kerikun11/AkiShelf/README.md

# AkiShelf
Display of Akizuki's Shelf Number
