kerikun11/AkiShelf/kicad/aki-shelf.pdf

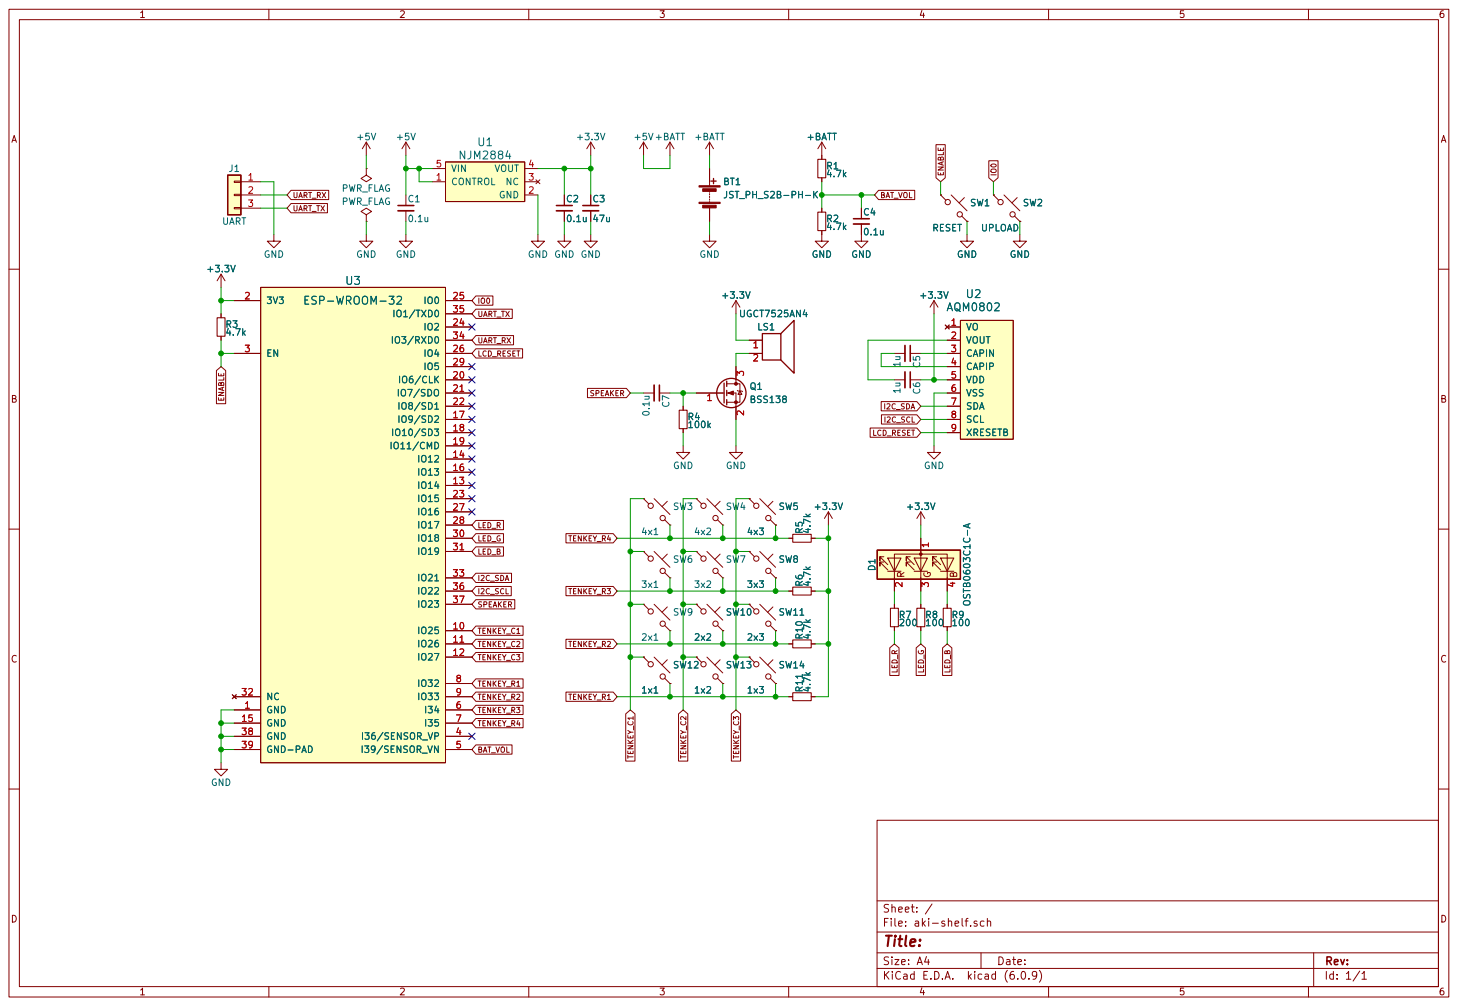
[picture p1: page 1]

Id: 1/1 Title: File: aki-shelf.sch Sheet: / SW7
