kerikun11/AkiShelf/(list of files, drawings)

Other design files:
kicad/aki-shelf.dsn
