kerikun11/AkiShelf/kicad/aki-shelf.kicad_pcb

## KiCad design kicad/aki-shelf.kicad_pcb (2018-04-30)

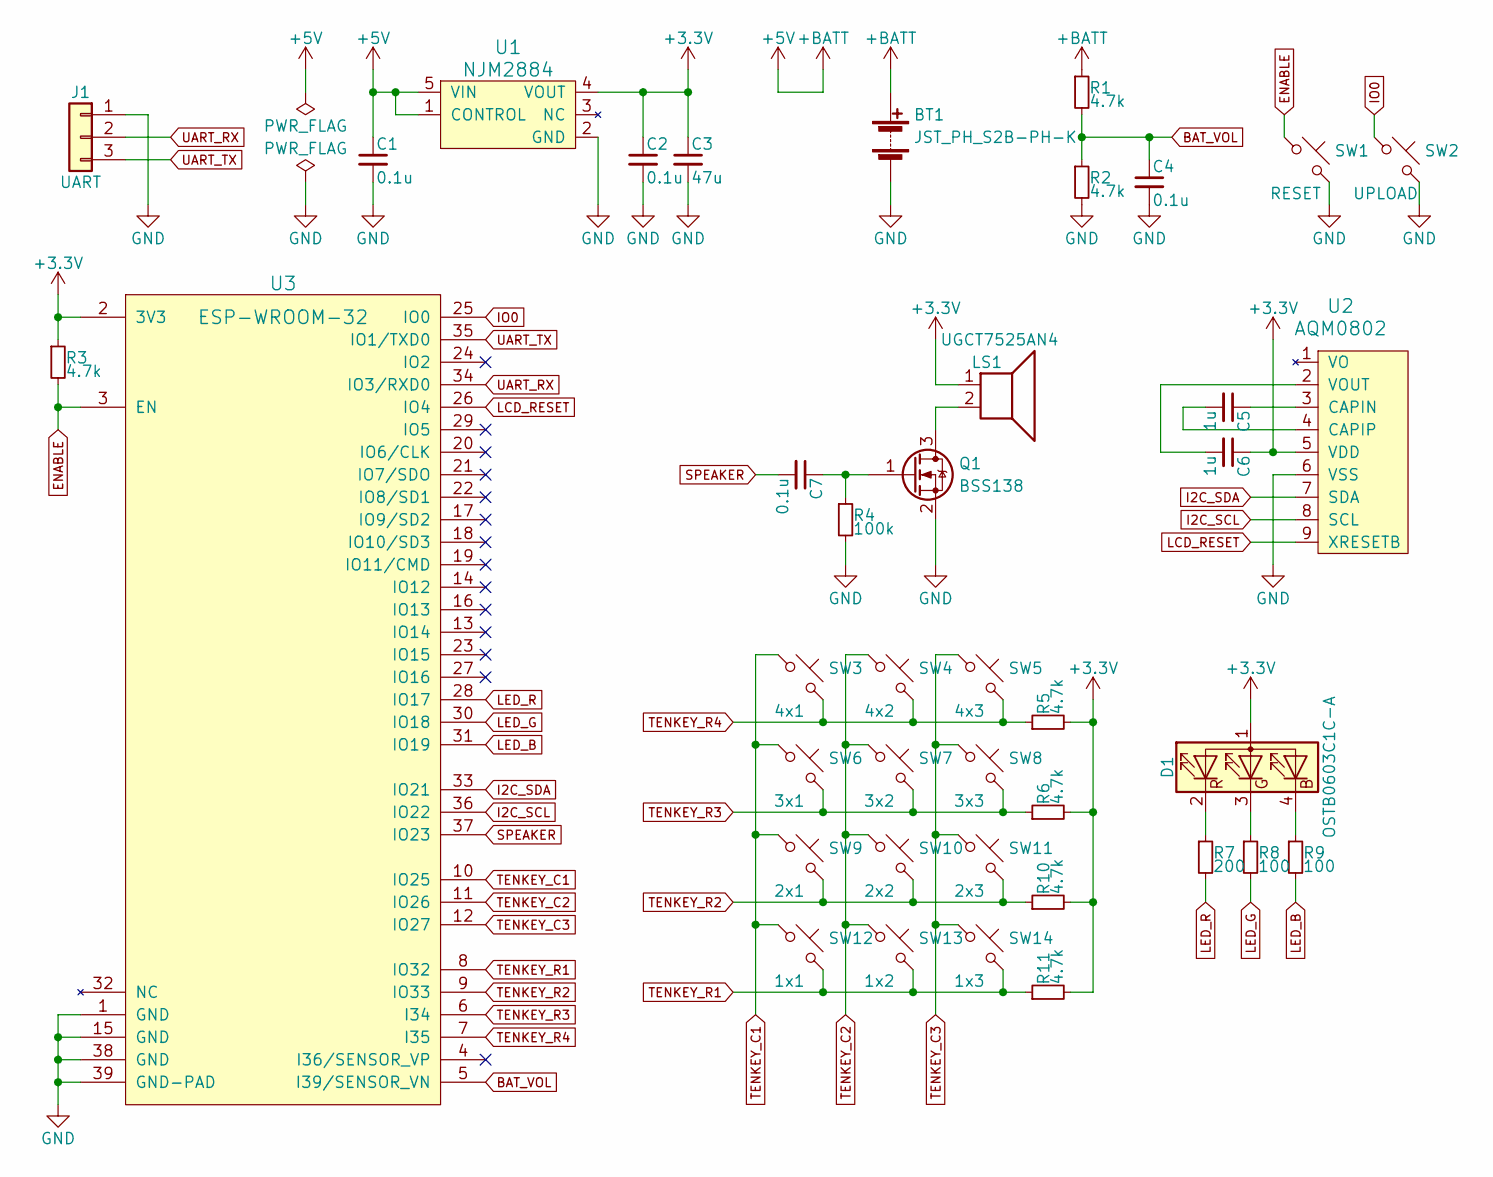
[picture p2: schematic aki-shelf.sch]

Parts:
BT1: JST_PH_S2B-PH-K; JST_PH_S2B-PH-K_02x2.00mm_Angled
C1, C2, C4, C7: 0.1u; C_0603
C3: 47u; C_1206
C5, C6: 1u; C_0603
D1: OSTB0603C1C-A
J1: UART; Socket_Strip_Straight_1x03_Pitch2.54mm
LS1: UGCT7525AN4
Q1: BSS138; SOT-23
R1, R2, R3, R5, R6, R10, R11: 4.7k; R_0603
R4: 100k; R_0603
R7: 200; R_0603
R8, R9: 100; R_0603
SW1: RESET; SKRPACE010
SW2: UPLOAD; SKRPACE010
SW3: 4x1; SKRPACE010
SW4: 4x2; SKRPACE010
SW5: 4x3; SKRPACE010
SW6: 3x1; SKRPACE010
SW7: 3x2; SKRPACE010
SW8: 3x3; SKRPACE010
SW9: 2x1; SKRPACE010
SW10: 2x2; SKRPACE010
SW11: 2x3; SKRPACE010
SW12: 1x1; SKRPACE010
SW13: 1x2; SKRPACE010
SW14: 1x3; SKRPACE010
U1: NJM2884; SOT-89-5_Housing
U2: AQM0802; AQM0802A-RN-GBW
U3: ESP-WROOM-32

Connections:
+3V3: C2.1, C3.1, C6.1, D1.1 (A), LS1.1, R3.1, R5.2, R6.2, R10.2, R11.2, U1.4 (VOUT), U2.5 (VDD), U3.2 (3V3)
+5V: BT1.1 (+), C1.1, R1.1, U1.1 (CONTROL), U1.5 (VIN)
BAT_VOL: C4.1, R1.2, R2.1, U3.5 (I39/SENSOR_VN)
ENABLE: R3.2, SW1.1, U3.3 (EN)
GND: BT1.2 (-), C1.2, C2.2, C3.2, C4.2, J1.1, Q1.2 (S), R2.2, R4.2, SW1.2, SW2.2, U1.2 (GND), U2.6 (VSS), U3.1 (GND), U3.15 (GND), U3.38 (GND), U3.39 (GND-PAD)
I2C_SCL: U2.8 (SCL), U3.36 (IO22)
I2C_SDA: U2.7 (SDA), U3.33 (IO21)
IO0: SW2.1, U3.25 (IO0)
LCD_RESET: U2.9 (XRESETB), U3.26 (IO4)
LED_B: R9.2, U3.31 (IO19)
LED_G: R8.2, U3.30 (IO18)
LED_R: R7.2, U3.28 (IO17)
unnamed: C5.1, U2.3 (CAPIN)
unnamed: C5.2, U2.4 (CAPIP)
unnamed: C6.2, U2.2 (VOUT)
unnamed: C7.1, Q1.1 (G), R4.1
unnamed: D1.2 (RK), R7.1
unnamed: D1.3 (GK), R8.1
unnamed: D1.4 (BK), R9.1
unnamed: LS1.2, Q1.3 (D)
SPEAKER: C7.2, U3.37 (IO23)
TENKEY_C1: SW3.1, SW6.1, SW9.1, SW12.1, U3.10 (IO25)
TENKEY_C2: SW4.1, SW7.1, SW10.1, SW13.1, U3.11 (IO26)
TENKEY_C3: SW5.1, SW8.1, SW11.1, SW14.1, U3.12 (IO27)
TENKEY_R1: R11.1, SW12.2, SW13.2, SW14.2, U3.8 (IO32)
TENKEY_R2: R10.1, SW9.2, SW10.2, SW11.2, U3.9 (IO33)
TENKEY_R3: R6.1, SW6.2, SW7.2, SW8.2, U3.6 (I34)
TENKEY_R4: R5.1, SW3.2, SW4.2, SW5.2, U3.7 (I35)
UART_RX: J1.2, U3.34 (IO3/RXD0)
UART_TX: J1.3, U3.35 (IO1/TXD0)

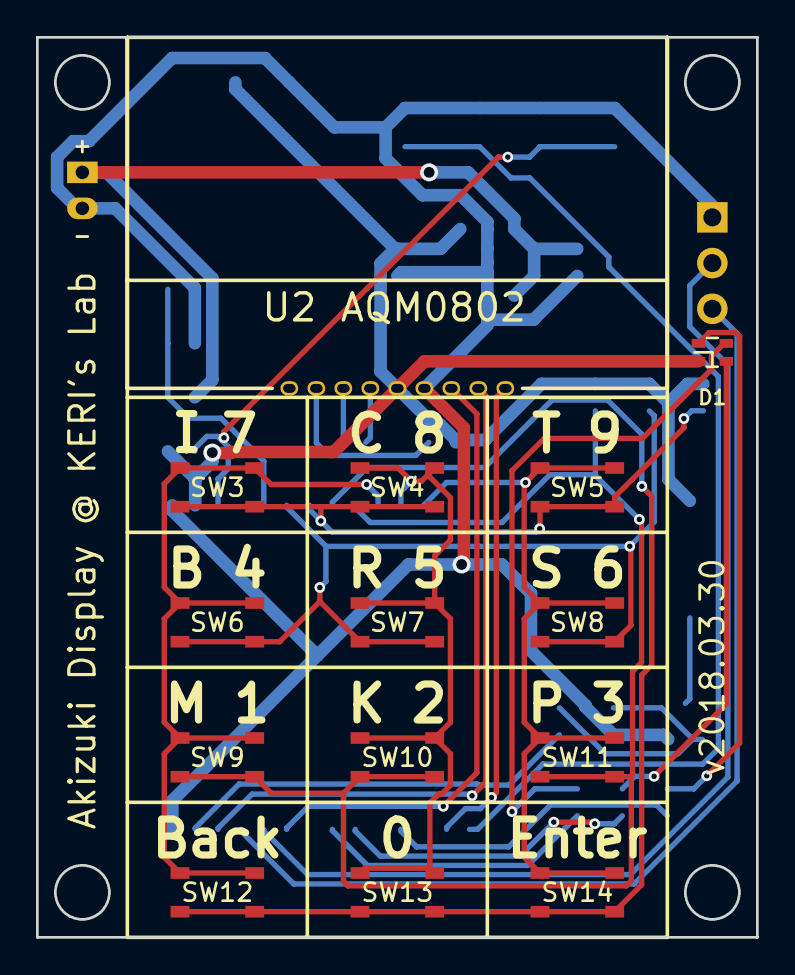
[picture p3: board aki-shelf.kicad_pcb from above]

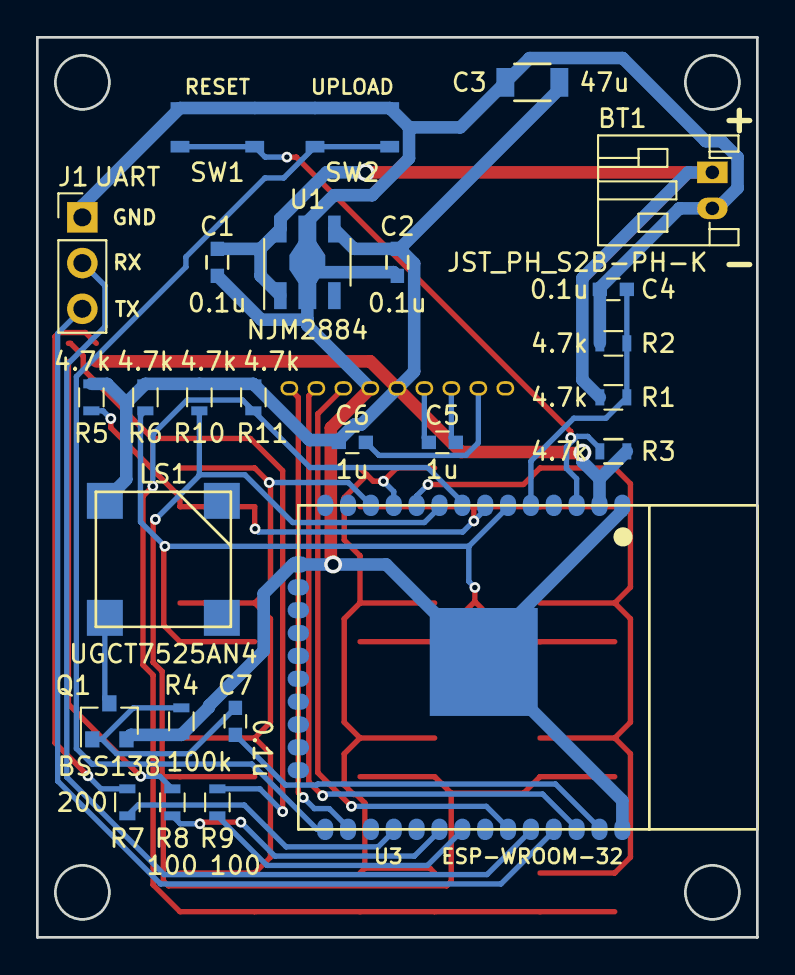
[picture p4: board aki-shelf.kicad_pcb from below]

Board: 2 copper layers, 40.0 x 50.0 mm, 40 parts (26 on the bottom side), 30 nets.
