kerikun11/AkiShelf/arduino/aki-shelf/aki-shelf.ino

/**
   @file    aki-shelf.ino
   @author  KERI (Github:kerikun11)
   @date    2018.02.22
*/
#include <WiFi.h>
#include <Wire.h>
#include <ArduinoOTA.h>
#include <driver/rtc_io.h>
#include "config.h"
#include "ST7032.h"
#include "tenkey.h"
#include "buzzer.h"
#include "button.h"
#include "AkiShelf.h"
#include "led.h"

Buzzer bz(BUZZER_PIN, LEDC_BUZZER_CH);
Button btn(BUTTON_PIN);
ST7032 lcd;
Tenkey key(PINS_TENKEY_ROW, PINS_TENKEY_COL);
LED led(PIN_LED_RED, PIN_LED_GREEN, PIN_LED_BLUE);
AkiShelf aki;

xSemaphoreHandle xSleepSemaphore = NULL;  //< 自動スリープのためのセマフォハンドル

void setup() {
  Serial.begin(115200);
  log_i("************************ Aki-Shelf ************************");
  bz.begin();
  bz.play(Buzzer::SUCCESSFUL);

  // WiFi 設定
  WiFi.onEvent([](WiFiEvent_t event) {
    switch (event) {
      case ARDUINO_EVENT_WIFI_STA_CONNECTED:
        log_i("WiFi STA Connected");
        break;
      case ARDUINO_EVENT_WIFI_STA_GOT_IP:
        log_i("WiF STA Got IP %s", WiFi.localIP().toString().c_str());
        break;
      case ARDUINO_EVENT_WIFI_STA_DISCONNECTED:
        log_i("WiFi STA Disconnected");
        break;
      default:
        break;
    }
  });
  // 前回接続したWiFiに自動接続
  WiFi.begin();

  // RTC-GPIOの解放
  esp_sleep_pd_config(ESP_PD_DOMAIN_RTC_PERIPH, ESP_PD_OPTION_OFF);

  // LCDの起動
  pinMode(LCD_RESET_PIN, INPUT_PULLUP);
  Wire.begin();
  lcd.begin(8, 2);
  lcd.noAutoscroll();
  lcd.setContrast(30);
  lcd.clear();
  lcd.setCursor(0, 0);
  lcd.print("Akizuki");
  lcd.setCursor(0, 1);
  lcd.print("Shelf #");

  // 自動スリープのためのタスク
  vSemaphoreCreateBinary(xSleepSemaphore);
  xTaskCreate(sleep_task, "sleep", 4096, NULL, 1, NULL);
  // WiFi接続変更用タスク
  xTaskCreate(smartConfig_task, "smartConfig", 4096, NULL, 1, NULL);
  // ファームウェア更新用タスク
  xTaskCreate(ota_task, "ota", 4096, NULL, 1, NULL);

  xSemaphoreGive(xSleepSemaphore);  //< スリープ延期

  key.read();
  bz.play(Buzzer::SELECT);
}

String getCodeFromKey() {
  lcd.clear();
  lcd.setCursor(0, 0);
  lcd.print("Code?");
  lcd.setCursor(0, 1);
  lcd.print("X-XXXXX");
  const char code_alphabet[] = "MKPBRSICT";
  String code;
  char alphabet = '_';
  int number = 0;
  int state = 0;
  while (1) {
    char c = key.read();
    bz.play(Buzzer::SELECT);
    led.blink(LED::GREEN, 100);
    xSemaphoreGive(xSleepSemaphore);  //< スリープ延期
    switch (state) {
      case 0:
        if (c >= '1' && c <= '0' + strlen(code_alphabet)) {
          alphabet = code_alphabet[c - '0' - 1];
          state = 1;
        }
        break;
      default:
        if (c == 'L') {
          if (number == 0) {
            alphabet = '_';
            state = 0;
          }
          number /= 10;
        } else if (c == 'R') {
          return code;
        } else {
          number *= 10;
          number += c - '0';
          number %= 100000;
        }
        break;
    }
    code = AkiShelf::parts2code(alphabet, number);
    lcd.setCursor(0, 1);
    lcd.print(code);
  }
}

void loop() {
  String code = getCodeFromKey();
  led.setBackground(LED::GREEN);
  lcd.clear();
  lcd.setCursor(0, 0);
  lcd.print("Please");
  lcd.setCursor(0, 1);
  lcd.print("wait...");
  if (WiFi.waitForConnectResult() != WL_CONNECTED) {
    log_e("wifi connection failed :(");
    lcd.clear();
    lcd.setCursor(0, 0);
    lcd.print("WiFi Con");
    lcd.setCursor(0, 1);
    lcd.print("Failed:(");
    log_i("Tenkey: %c\n", key.read());
    led.setBackground(LED::OFF);
    return;
  }
  enum AkiShelf::STATUS_CODE status = aki.get(code);
  led.setBackground(LED::OFF);
  String lcd_str[2];
  switch (status) {
    case AkiShelf::SUCCESSFUL:
      bz.play(Buzzer::SUCCESSFUL);
      led.blink(LED::BLUE, 500);
      lcd_str[0] = (String) "Qty:" + String(aki.getQty(), DEC);
      lcd_str[1] = aki.getShelf();
      break;
    case AkiShelf::CONNECTION_FAILED:
      bz.play(Buzzer::ERROR);
      led.blink(LED::RED, 500);
      lcd_str[0] = "Connect";
      lcd_str[1] = "Failed!";
      break;
    case AkiShelf::RESPONSE_TIMEOUT:
      bz.play(Buzzer::ERROR);
      led.blink(LED::RED, 500);
      lcd_str[0] = "Response";
      lcd_str[1] = "Timeout!";
      break;
    case AkiShelf::INVALID_FORMAT:
      bz.play(Buzzer::ERROR);
      led.blink(LED::RED, 500);
      lcd_str[0] = "Format";
      lcd_str[1] = "Error!";
      break;
    case AkiShelf::NOT_FOUND:
      bz.play(Buzzer::ERROR);
      led.blink(LED::RED, 500);
      lcd_str[0] = "Not";
      lcd_str[1] = "Found!";
      break;
  }
  lcd.clear();
  lcd.setCursor(0, 0);
  lcd.print(lcd_str[0]);
  lcd.setCursor(0, 1);
  lcd.print(lcd_str[1]);
  log_i("Tenkey: %c\n", key.read());
  bz.play(Buzzer::SELECT);
}

/**
   @brief 一定時間操作がなければ自動的にスリープ状態にするタスク
   WDTのように，
   xSemaphoreGive(xSleepSemaphore);
   が一定時間よばれなければ，自動的にスリープ状態へ
*/
void sleep_task(void *arg) {
  while (xSemaphoreTake(xSleepSemaphore, AUTO_SLEEP_TIME_S * 1000 / portTICK_RATE_MS) == pdTRUE) {}
  bz.play(Buzzer::CANCEL);
  delay(200);
  // LCDの無効化
  pinMode(LCD_RESET_PIN, INPUT_PULLDOWN);
  // WiFi の無効化
  WiFi.mode(WIFI_OFF);
  // ウェイクアップ用 RTC-GPIO の設定
  rtc_gpio_pulldown_en(GPIO_NUM_25);
  rtc_gpio_pulldown_en(GPIO_NUM_26);
  rtc_gpio_pulldown_en(GPIO_NUM_27);
  esp_sleep_pd_config(ESP_PD_DOMAIN_RTC_PERIPH, ESP_PD_OPTION_ON);
  esp_sleep_enable_ext1_wakeup(0x7 << 25, ESP_EXT1_WAKEUP_ANY_HIGH);
  // スリープへ
  log_i("Going to sleep now");
  esp_deep_sleep_start();
}

/** smartConfig処理をするタスクの関数
  @brief FreeRTOSにより実行，ボタンが押されたらsmartConfig処理を実行
*/
void smartConfig_task(void *arg) {
  portTickType xLastWakeTime = xTaskGetTickCount();
  {
    while (!btn.pressed)
      vTaskDelayUntil(&xLastWakeTime, 1 / portTICK_RATE_MS);
    btn.flags = 0;
    lcd.clear();
    lcd.setCursor(0, 0);
    lcd.printf("Battery");
    lcd.setCursor(0, 1);
    lcd.printf("%.3f V", analogReadMilliVolts(BATTERY_PIN) * 2 / 1000.0f);
  }
  {
    while (!btn.pressed)
      vTaskDelayUntil(&xLastWakeTime, 1 / portTICK_RATE_MS);
    btn.flags = 0;
    lcd.clear();
    IPAddress local_ip = WiFi.localIP();
    lcd.setCursor(0, 0);
    lcd.printf("%d.%d.", local_ip[0], local_ip[1]);
    lcd.setCursor(0, 1);
    lcd.printf("%d.%d", local_ip[2], local_ip[3]);
  }
  {
    while (!btn.pressed)
      vTaskDelayUntil(&xLastWakeTime, 1 / portTICK_RATE_MS);
    btn.flags = 0;
    bz.play(Buzzer::CONFIRM);
    log_i("WiFi.beginSmartConfig();");
    lcd.clear();
    lcd.setCursor(0, 0);
    lcd.print("Smart");
    lcd.setCursor(0, 1);
    lcd.print("Config...");
    WiFi.mode(WIFI_AP_STA);
    WiFi.beginSmartConfig();
    while (!WiFi.smartConfigDone()) {
      delay(100);
      xSemaphoreGive(xSleepSemaphore);  //< スリープ延期
    }
  }
  vTaskDelay(portMAX_DELAY);
}

/** OTA処理をするタスクの関数
  @brief FreeRTOSにより実行
*/
void ota_task(void *arg) {
  ArduinoOTA.setHostname("AkiShelf");
  ArduinoOTA.onProgress([](int progress, int total) {
    xSemaphoreGive(xSleepSemaphore);  //< スリープ延期
  });
  ArduinoOTA.begin();
  portTickType xLastWakeTime = xTaskGetTickCount();
  while (1) {
    vTaskDelayUntil(&xLastWakeTime, 1 / portTICK_RATE_MS);
    ArduinoOTA.handle();
  }
}
