kerikun11/AkiShelf/arduino/aki-shelf/config.h

#pragma once

/* hardware mapping */
#define BUZZER_PIN          23
#define PIN_LED_RED         17
#define PIN_LED_GREEN       19
#define PIN_LED_BLUE        18
#define BUTTON_PIN          0
#define LCD_RESET_PIN       4
#define BATTERY_PIN         39
#define PINS_TENKEY_ROW     {32, 33, 34, 35}
#define PINS_TENKEY_COL     {25, 26, 27}

/* LEDC channel */
#define LEDC_BUZZER_CH      4

/* settings */
#define AUTO_SLEEP_TIME_S   12
