kerikun11/AkiShelf/(commit log)

2018-02-21 ソースコードを追加
2018-02-21 KiCadファイルを追加
    [aki-shelf.dsn, aki-shelf.kicad_pcb, aki-shelf.sch]
2018-02-22 自動配線を適用
    [aki-shelf.dsn, aki-shelf.kicad_pcb, aki-shelf.sch]
2018-02-22 基板を両面にして小型化
    [aki-shelf.dsn, aki-shelf.kicad_pcb, aki-shelf.sch]
2018-02-24 穴径を3mmに変更
    貼り付けボスが使えるように
    [aki-shelf.dsn, aki-shelf.kicad_pcb, aki-shelf.sch]
2018-02-25 ログ出力を改良
2018-03-10 LEDの点灯コードを追加
2018-04-30 基板を改良
    スイッチの位置，スピーカーの回路など
    [aki-shelf.dsn, aki-shelf.kicad_pcb, aki-shelf.sch]
2023-01-02 リダイレクトのエラーを修正
2023-01-02 platformio.ini を追加
2023-01-02 回路図を追加
